borkymcgee/Ascii_Annihilator/Hardware/back.png

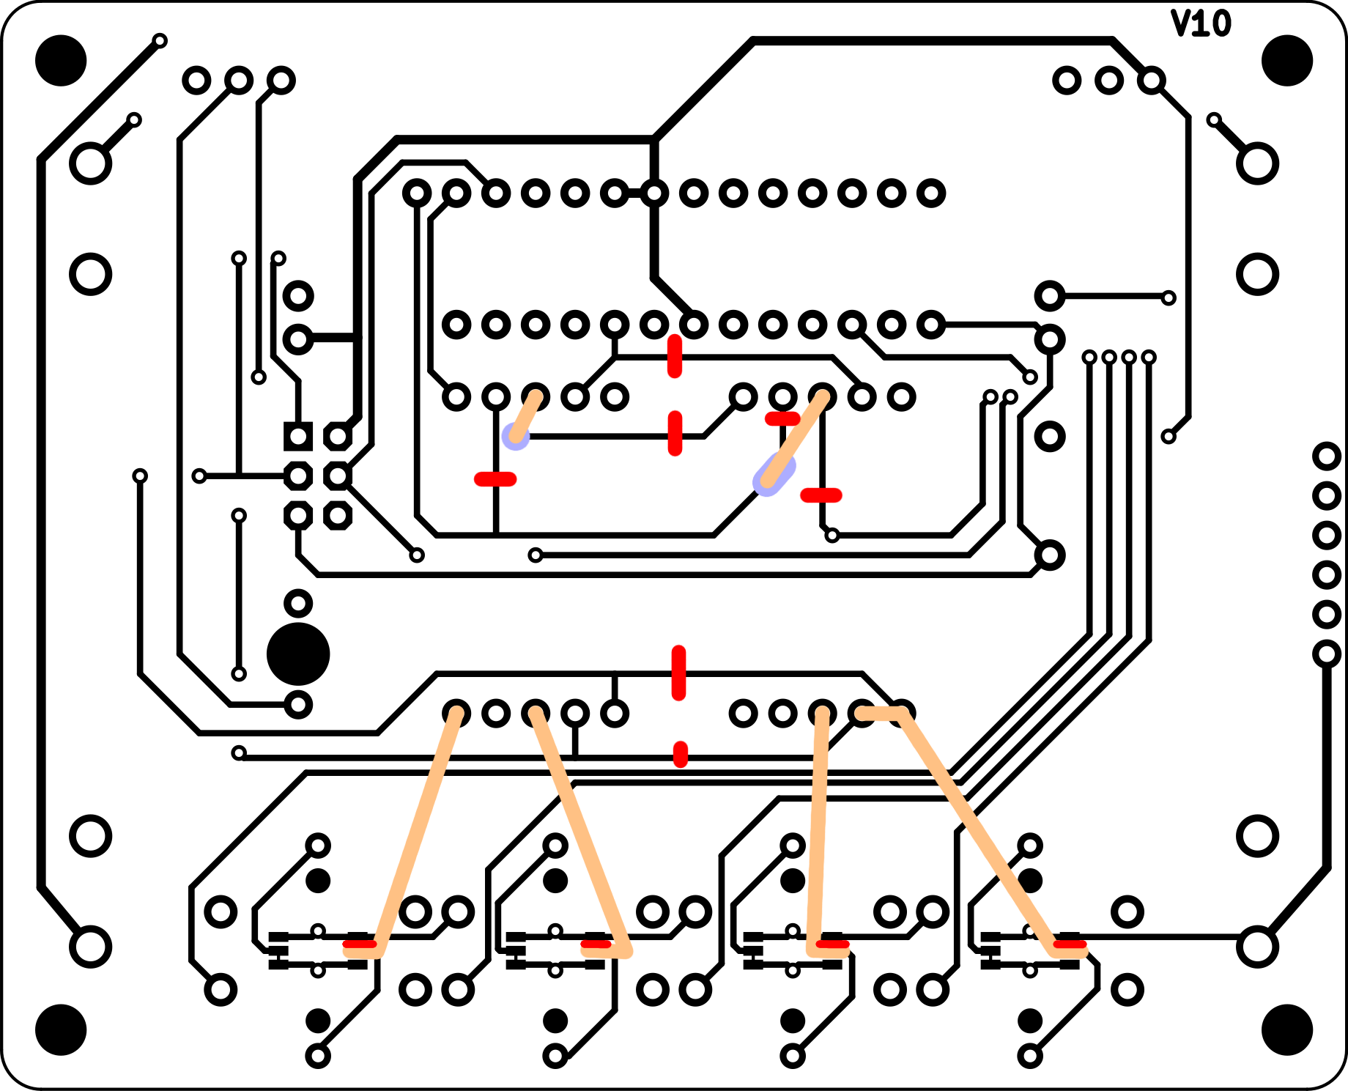
Hardware/back.png
