borkymcgee/Ascii_Annihilator/Hardware/front.png

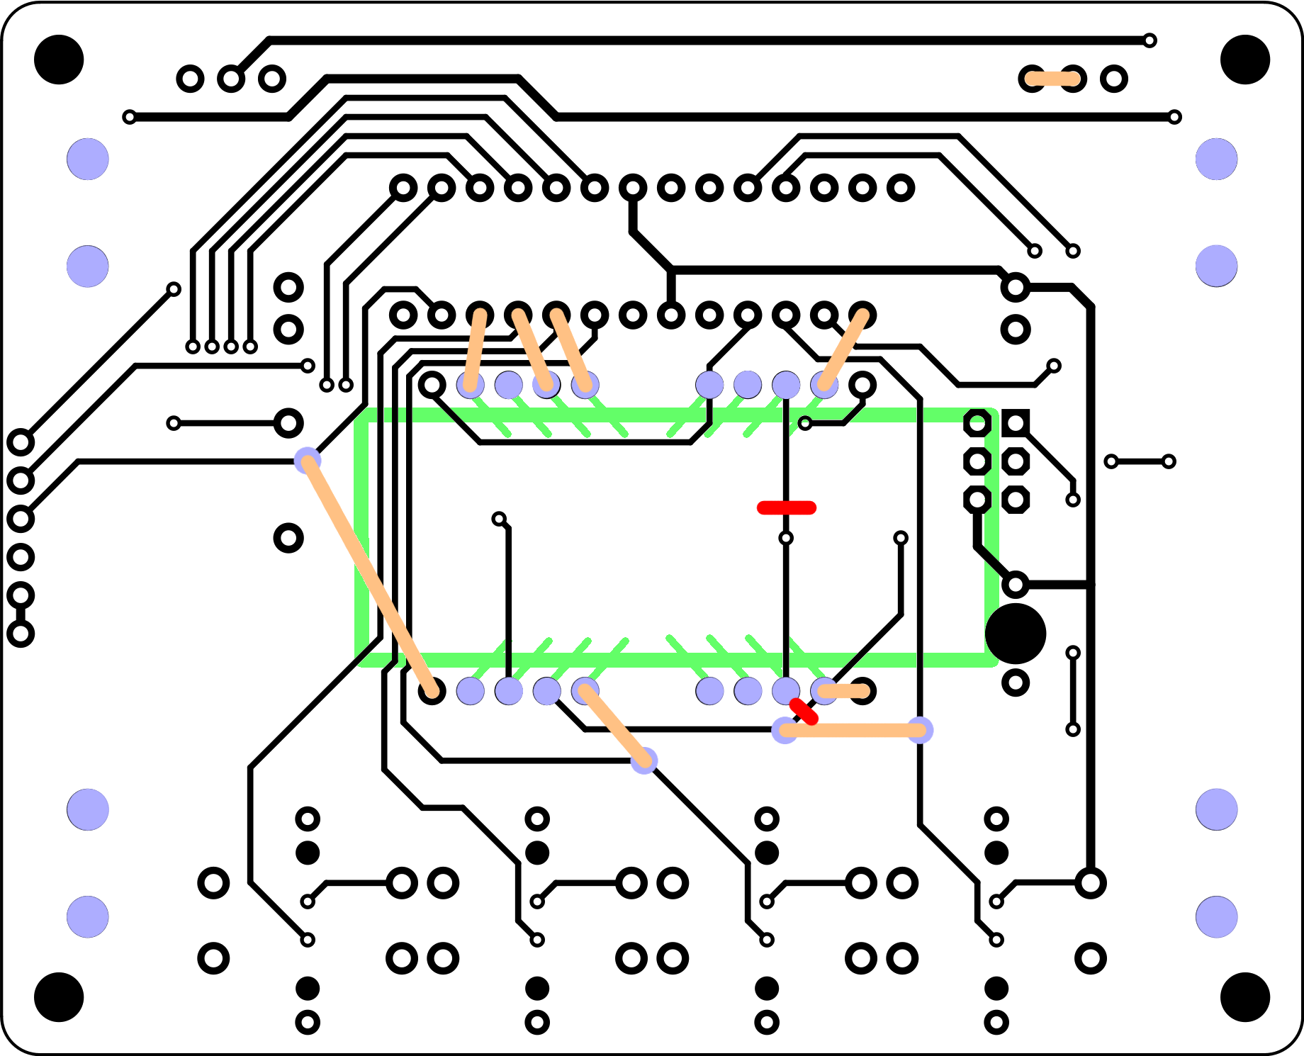
Hardware/front.png
