borkymcgee/Ascii_Annihilator/(commit log)

2022-03-04 Added button test code
    Pressing different buttons will now display various curse words as a test of the functionality of the buttons
2022-03-04 Establish framework to display characters
    Establish a framework to display characters on the display on command. A framebuffer is created storing the current state of the display, and it is updated once/loop, iterating through the different sections to be addressed. A function is added to iterate through the printable ascii and display each char in sequence on the display.
2022-03-08 Added game modes, button code
    Big commit time, this commit adds a main game mode that quizzes the user on all ascii characters, a 'table' mode that allows the user to browse a virtual ascii table, and a mode wherein you can put in any binary number and it'll give you the corresponding character. also added code to poll the buttons and the nibble switch.
2022-03-09 Juno mode added!
    removed look, table modes, reworked main game mode. all subgame modes can now be combined in any combination, showing the selection on boot. randomness was also improved, preventing a set seed unless all buttons are pressed on boot.
    [Ascii_Annihilator.ino]
2022-03-09 Add timer, penny pinch power
    Added a timer that, upon completing a mode, tells the user how long they took to complete it. also did some things to penny-pinch some power (these will be needed later for sleep mode)
2022-03-09 Button-specific debouncing
    Buttons are now individually debounced, allowing several to be pressed at once
2022-03-09 Modified segment-to-ascii encoding
    Moved encoding of printing ascii characters from a large switch statement to a lookup table. I am intending to use the F() macro (or similar) to move this to flash to save a significant amount of memory (~200B)
2022-03-10 default to displaying strings right-justified
    displayString now accepts strings less than 4 chars long, in which case the string is right justified (saved ~100B of memory)
2022-04-21 hardware docs, fixed broken string code
    Added hardware docs, including images and a rudimentary walkthrough for hardware assembly
    fixed broken code for right-justifying strings
    [Ascii_Annihilator.ino]
2022-04-21 Added potential alternate wimp mode
    Added a new mode that can be enabled by changing aWimp to true, in this mode, wimp mode will either quiz you on the upper or lower nibble ONLY depending on the position of the nibble switch
2022-07-28 Changed nibble switch to pin 6 to reflect updated layout
2022-09-17 Update README.md
    added a bad pic of the prototype
2022-09-26 set nibble switch pin as input
    spent an hour finding this issue, it was a single bit *facepalm*
    [Ascii_Annihilator.ino]
2022-09-26 Fixed randomness bug
    Typo caused the rng to be seeded after every GAME instead of every QUESTION
    [Ascii_Annihilator.ino]
2023-04-02 Added High Score tracking for each gamemode individually High score gets stored in EEPROM High score is displayed at beginning of game if any buttons are being held on start
    Time taken will no longer display garbage when attempting to display times higher than 99:59
    fixed minor, harmless bugs to increase readibility
    [Ascii_Annihilator.ino]
2023-04-02 Changed nibble pin switch back to the correct pin
    [Ascii_Annihilator.ino]
2023-04-07 Compensated score timer for time spent displaying messages
