borkymcgee/Ascii_Annihilator/(notices)

Notices in the files:
Ascii_Annihilator.ino:
under the terms of the GNU General Public License as published by the
Free Software Foundation, either version 3 of the License, or (at your
